electrucio/electrucio_updates/junk/guitar_preamplifier/docs/preamp_design.md

# AI-assisted redesign of a guitar preamplifier

I am not an expert on electronics. My actual background includes a PhD in digital audio processing, and my daily job involves software engineering, machine learning, signal processing... but no electronics at all. However, I recently realized I really enjoy learning about analog electronics, so here I am.

In this article, I explain how I have been experimenting with an AI agent to understand and adapt an existing guitar preamplifier to my requirements. I used AI for three main purposes:

* Understand an baseline existing design
* Brainstorm improvements suggestions
* Introduce changes in the existing design with verifiable metrics, using LTSpice simulation

Guitar preamplifier design from RedCircuits.com (https://www.dropbox.com/scl/fi/j1w2b3latuc1dzcs9ssm6/ia_usage_schema.png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)

I have learned a lot during the process, so I hope it can be inspiring for other people too. I invite any expert to provide feedback that help to improve the approach.

## 1. My requirements
Let's assume these are my requirements for a guitar amplifier.
* ✅ Input suitable for a standard guitar pickup
* ✅ Output suitable for a standard power amplifier
* ✅ Power voltage 0-15V
* ✅ Four knobs: Drive, Bass, Treble, Volume
* ✅ This is not a lab exercise: it has to work in real-world
* ✅ Discrete parts only, no op-amps.

## 2. Starting point: a schematic from redcircuits.com

For my exercise, I've used this project as a starting point: https://www.redcircuits.com/Page65.htm

Guitar preamplifier design from RedCircuits.com (https://www.redcircuits.com/GuitarPre.GIF)

Is this design enough for us?
* ❓ Input suitable for a standard guitar pickup
* ❓ Output suitable for a standard power amplifier
* ❌ Power voltage 0-15V
* ❌ Four knobs: Drive, Bass, Treble, Volume
* ❓ Properly designed, it should work as expected
* ✅ Discrete parts only, no op-amps.

Let's investigate if my requirements are met, with the help of LTSpice and Gemini.

## 3. LTSpice simulation

Let's begin with a simulation of the existing preamplifier: **does it work?**

### 3.1. Transient analysis using a 0.5 Vpeak, 1 kHz sine wave
According to [Rod Elliot](https://sound-au.com/articles/guitar-voltage.htm), a value of 0.5 Vpeak is rather high for guitar pickups, but still realistic for some models, so we will use this input amplitude in our analysis.

LTSpice simulation circuit (https://www.dropbox.com/scl/fi/t5rb5kocnawi6e06ufliy/original_design.png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)

After running this simulation, for `drive=0` (and the rest of parameters as shown in the figure) we get these results in our `.log` file:
| Node | Vmean | Vmin | Vmax | %THD |
| :--- | :--- | :--- | :--- | :--- |
| **V(in)** | 0.00 | -0.50 | 0.50 | 0.00% |
| **V(q1b)** | 2.50 | 2.12 | 2.88 | 0.00% |
| **V(q2c)** | 32.53 | 25.78 | 39.29 | 0.02% |
| **V(mid_in)** | 0.00 | -6.76 | 6.75 | 0.02% |
| **V(tone_in)** | 0.00 | -6.42 | 6.42 | 0.02% |
| **V(tone_out)**| 0.00 | -2.10 | 2.10 | 0.02% |
| **V(q3b)** | 27.57 | 25.47 | 29.67 | 0.02% |
| **V(q3e)** | 26.92 | 24.82 | 29.01 | 0.03% |
| **V(out)** | 0.00 | -2.09 | 2.09 | 0.03% |

If we activate the distortion (`drive=1`):
| Node | Vmean | Vmin | Vmax | %THD |
| :--- | :--- | :--- | :--- | :--- |
| **V(in)** | 0.00 | -0.50 | 0.50 | 0.00% |
| **V(q1b)** | 2.50 | 2.13 | 2.88 | 1.48% |
| **V(q2c)** | 32.81 | 27.56 | 39.13 | 9.16% |
| **V(mid_in)** | 0.00 | -5.21 | 6.32 | 9.16% |
| **V(tone_in)** | 0.00 | -3.09 | 3.35 | 23.26% |
| **V(tone_out)**| 0.00 | -1.73 | 1.74 | 33.37% |
| **V(q3b)** | 27.57 | 25.84 | 29.31 | 33.37% |
| **V(q3e)** | 26.92 | 25.19 | 28.65 | 33.37% |
| **V(out)** | 0.00 | -1.73 | 1.73 | 33.37% |

On on the other hand:
* Input impedance is 285kΩ 
* Output impedance is 10kΩ

Some preliminary conclusion about how well this design meets my requirements:

### 3.2. AC analysis: frequency response
Using a python script and `spicelib`, with the help of Gemini, I used `matplotlib` to create a beautiful plot that illustrates what happens with our preamplifier when you modify `bass` and `treble` controls. We will ignore `brightness` control.

LTSpice simulation circuit (https://www.dropbox.com/scl/fi/cmu691a0sbsxga6ana50k/original_design_ac_analysis.png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)

Not sure if this frequency response will produce a beautiful sound, but it is clearly working more or less as expected for both `bass` and `treble` controls.

## 4. Understanding each section of the circuit
So far, the results provided by the previous analysis look good, and Gemini a priori says the design is properly done. Now, let's spend some time understanding each part of the circuit. This might help in later stages, and is a good learning exercise.

### 4.1. The input stage

I know how to analyze basic transistor circuits, but I am not familiar with this specific topology. Gemini to the rescue:

> 1. The "Direct-Coupled Feedback Pair" (specifically an NPN-PNP pair)
This is the practical, schematic-level name.
> "Direct-Coupled" means there is no blocking capacitor between the collector of Q1 and the base of Q2. They are directly wired together.
> "Feedback Pair" means the two transistors operate as a single functional block bound by a global feedback loop.
> 2. The "Two-Stage Voltage-Series Feedback Amplifier"
This is the formal, academic name used in university physics and engineering books.
> "Voltage" means the feedback network (R7) is sampling the voltage at the output node (Q2's collector).
> "Series" means that the feedback is being injected into the emitter of Q1, which places it in series with the input signal arriving at the base.

After some iterations, I was able to find that **Two-Transistor Series-Feedback Gain Stages** is the right keyword for this topology:

LTSpice simulation circuit (https://www.dropbox.com/scl/fi/94ttidc72mrazcleyqloo/input_stage.png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)

I also wonder... why are we adding C3 here?

>In electronics literature, this specific component is universally known as a **Miller compensation capacitor** (or sometimes a **dominant-pole compensation capacitor**).
> Because your circuit uses global negative feedback (R7 and R8), there is a danger that at very high (radio) frequencies, natural phase shifts inside the transistors will turn that _negative_ feedback into _positive_ feedback, causing the amplifier to violently oscillate. C3 intentionally uses the "Miller Effect" to roll off the high-frequency gain of Q2, keeping the amplifier stable.

Ok, let's believe this.

**Understanding DC analysis**

After some iteration, I also understood the key aspects of this topology to perform a DC analysis (after opening all capacitors). If we do a rough approximation (ignoring $I_{2b}$, ignoring the effect of R4 on the voltage divider...):

* $V_{be}$ voltages are constant ~0.65v, so we know $V_{R6} = 0.65$ V.
* Since we know $V_{2b}$, we can know $I_{R6} = 0.65 / 2k2 = 295$µA, which is very similar to $I_{1c}$.
* As we know $I_{1c}$, we can know $I_{1b}$, since $I_{1b} = I_{1c}/\beta_{1} =295 / 344 = 0.86$µA.
* As we know $I_{1b}$ we can know the voltage in $R4$: $V_{R4} = I_{1b} R4 = 0.86 \cdot 10^{-6} \cdot 220 \cdot 10^{3} = 0.19$ V. We can then subtract the voltage in R4 to the voltage produced by the divider made of R3 and R5, and compute $V_{1b} = 57.08 \cdot \frac{33k}{(680k + 33k)} - 0.19=2.45$ V.
* Then we can compute $V_{1e} = V_{1b} - 0.6 = 2.45 - 0.6 = 1.85$, and then we can compute $I_{R8} = 1.85 / 330 = 5.6$ mA.
* $I_{R8} = I_{1e} + I_{2c}$. We know that $I_{1e} \approx I_{1c} = 295$µA, so we can estimate $I_{2c} = 5.6 - 0.295 = 5.3$mA.
* $V_{R7} = I_{2c} \cdot R7 = 5.3 \cdot 5k6 \approx 30$ V, so $V_{2c} = 30 + 1.85 \approx 32$ V. In LTSpice we get 32.52V instead of 32v because of the approximations mentioned before.

**Some considerations about AC analysis**

For AC analysis, we put our voltage supply to ground, and we consider all coupling and decoupling capacitors as close circuits, but what about Miller capacitor C3? Gemini suggests to treat it as an open circuit because we are interested in the audio bandwidth, and its reactance for these frequencies is very high.

Gemini says:
> When you strip away all the DC bias components, what you are left with is a textbook **Non-Inverting Operational Amplifier** made of discrete parts.

And it says that the amplification factor of a non-inverting op. amp is $$A_v \approx 1 + \frac{R_7}{R_8} \approx 17.97$$
In LTSpice I get $17.7$, so I guess it is correct as an approximation. Let's go on.

### 4.2. Diode clipper stage

Let's go with the analysis of the diode clipping stage in the mid section.
LTSpice simulation circuit (https://www.dropbox.com/scl/fi/odon4j8sfq4g9190pmovh/mid_section.png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)

Again: I ask Gemini to find references in well-known literature to understand the design used in this schematic.

> ### The Clipping Stage: Self-Biasing / Dynamic Clipper
>**Components involved:** P4, D1, D2, C5, C6, R11.
> In standard guitar pedal or preamp literature, this is known as a **Self-Biasing Clipper**, **Dynamic Diode Clipper**, or **RC-Biased Clipper**.
> 
> **How it works:**
> -   **Standard Hard Clipping:** Usually, anti-parallel diodes are connected directly to ground. When the signal exceeds the diode's forward voltage (about 0.2V-0.3V for the BAT46 Schottky diodes used here), it clips the wave completely flat. This sounds very harsh and buzzy ("solid-state" sounding). 
> -   **The Dynamic Twist:** In this circuit, the diodes do not go directly to ground. D1 connects to C5, and D2 connects to C6. When a loud signal hits and a diode conducts, it charges its respective capacitor. 
> -   **The Tube Emulation Effect:** As C5 and C6 charge up, they introduce a DC bias voltage that essentially _raises_ the clipping threshold for the next wave. The harder you play, the higher the threshold pushes back. As the note decays, the capacitors discharge through R11, lowering the threshold again.
> -   **The Result:** This creates a dynamic, "rubbery" feel that responds to pick attack, commonly referred to as "sag." It is a well-known solid-state technique used to emulate the asymmetrical duty-cycle shift and grid-clipping characteristics of an overdriven 12AX7 vacuum tube. P4 acts as a variable series resistor to control how hard the signal hits this network, essentially acting as a "Drive" or "Shape" control.

I used a guitar recording as input in V1 (`wavefile="../../audios/dry_guitar_5s.wav"`), and I was able to observe the behavior described by Gemini: the capacitors create a envelope follower, so the bias of the diode clipping is dynamic, allowing more dynamics than just the two diodes to ground. I also recorded the output using `.wave` LTSpice directive.

[Input audio](https://www.dropbox.com/scl/fi/7gtbvotlhn9sv4o5enonb/dry_guitar_5s.wav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)

[Output audio using current design with dynamic bias](https://www.dropbox.com/scl/fi/dpxmrngo414rtciz68wap/dynamicbias.mp3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)

[LTSpice simulation circuit](https://www.dropbox.com/scl/fi/le051e1n4w5vcthrkkw1h/current_design.png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
)

**What if we connect the diodes directly to ground?**

If we just put the two diodes to ground directly, ignoring R11, C5 and C6, what we get is a much more compressed waveform, closer to a fuzz.

LTSpice simulation circuit (https://www.dropbox.com/scl/fi/alwgj89ifa8pu3xz1xyx8/diodes_to_ground.png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)

[Output audio using diodes direct to ground](https://www.dropbox.com/scl/fi/p3ojo7l40lzo8owf800jt/directtoground.mp3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)

[LTSpice simulation circuit](https://www.dropbox.com/scl/fi/iqfelkhc3k6euz2srkwch/direct_to_ground.png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
)

**References about this dynamic-bias approach**
I have been investigating if this is a standard way of applying distortion in pedals or guitar preamps, but it does not seem to be very common. I found similar topologies for envelope followers, and I also found information about similar approaches in existing designs.

In "Solid-State Guitar Amplifiers" by Teemu Kyttälä, I was able to find references to a circuit that behaves similarly:

LTSpice simulation circuit (https://www.dropbox.com/scl/fi/iqkzpvlrjy71ldfnn4fuv/Captura-de-pantalla-2026-03-01-a-las-0.47.20.png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)

However, I was not able to find a previous design exactly as the one we are analyzing in our schematic.

### 4.3. Tone control
Let's remember again our tone stack, from original Red Circuits website:

LTSpice simulation circuit (https://www.dropbox.com/scl/fi/kuxyosqga2e4kmazmw1hs/Captura-de-pantalla-2026-03-01-a-las-2.31.31.png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)

Gemini describes this circuit this way:

> ### The Tone Control: The James Tone Network
> **Components involved:** C7, R12, P2 (Treble), P1 (Bass), R14, R15, R13, C9.
> 
> In literature, this specific topology is historically and technically known as the **James Tone Network** (created by E.J. James in 1949). However, in the guitar community, it is almost universally (and slightly incorrectly) referred to as a **Passive Baxandall** tone stack.
>
>**How it works:**
>
>-   Unlike the classic "FMV" (Fender/Marshall/Vox) tone stack which is highly interactive and naturally has a massive mid-scoop, the James network is designed to be much flatter and more independent.
>    
>-   **Treble Path:** The high frequencies pass through C7 and are controlled by P2.
>   
>-   **Bass Path:** The low frequencies are blocked by C7 but pass through R12 to be controlled by P1.
>    
> -   **Characteristics:** It provides genuine bass and treble _cut and boost_ relative to the baseline insertion loss of the circuit. If you set both P1 and P2 to 50% (as hinted by the `.param pos2=0.5` and `pos3=0.5` tags), you will get a relatively flat frequency response. The addition of R14, R15, and C9 in this specific variation acts as a shaping network to set the exact crossover frequency and control the midrange behavior between the two pots.
> 
> It looks like a very thoughtfully designed solid-state preamp aimed at capturing tube-like dynamics rather than just raw distortion.

I have been reviewing the topologies shown in https://www.guitarscience.net/tsc/james_2.htm, but I didn't find my exact topology. The most similar one is the James Tone Stack "Passive / Single Bass Capacitor":

LTSpice simulation circuit (https://www.dropbox.com/scl/fi/3uqhm2lyrnx169q2ykbwy/Captura-de-pantalla-2026-03-01-a-las-2.37.37.png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)

But it is not exactly the same! $C_B$ is not present in our design, and R3 (which in our case would be R14) is not connected to the same node. I was not able to find a reference about my specific tone stack, but I guess the main ideas behind it should be very similar.

### 4.4. The Output Stage: Bootstrapped Buffer (Q3)
LTSpice simulation circuit (https://www.dropbox.com/scl/fi/qlct4umq7ib7s93w4waea/output_buffer.png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)

> Based on the schematic provided, you are looking at a classic **Bootstrapped Emitter Follower** (also known as a Common Collector amplifier) circuit.
> 
> Here is a detailed breakdown of the topology and the specific role of each component.
> ### **Circuit Topology: The Bootstrapped Emitter Follower**
> The core of this circuit is the NPN transistor configured as an emitter follower. In a standard emitter follower, the input is applied to the base, the output is taken from the emitter, and the voltage gain is approximately 1 (unity). Its primary purpose is to act as a **buffer**: it provides a very high input impedance and a low output impedance, allowing you to drive a heavier load without loading down the previous stage.
>
>However, a standard biasing network (like a simple voltage divider) normally lowers the overall input impedance. This circuit solves that using a clever technique called **bootstrapping** (via C11 and R18), which artificially inflates the input impedance to a much higher value.
>
>---
>
>### **Role of the Components**
>
>#### **1. Power Supply & Decoupling**
>
>* **V2 (60V):** The main DC power supply for this stage.
>* **R21 ($330\Omega$) & C13 ($220\mu F$):** These form an RC low-pass filter (often called a decoupling or "RC snubber" network). They filter out high-frequency noise and power supply ripples from the 60V rail, providing a clean, quiet 57.08V DC supply to the transistor's collector.
>#### **2. The Active Component**
>
>* **Q3 (BC546B):** An NPN bipolar junction transistor (BJT) acting as the current buffer. It amplifies the current of the input signal while keeping the voltage level essentially the same (minus the base-emitter voltage drop, $V_{BE} \approx 0.65V$).
>
>#### **3. DC Biasing Network**
>
>These components establish the steady state (DC quiescent operating point) of the transistor so it stays in its active region to amplify AC signals without clipping.
>
>* **R17 ($100k\Omega$) & R19 ($100k\Omega$):** These form a voltage divider that sets an intermediate DC voltage (28.22V) at the junction between them.
>* **R20 ($10k\Omega$):** The emitter load resistor. It sets the quiescent DC current flowing through the transistor. Because the emitter sits at about 26.9V, the current is roughly $I_E = \frac{26.9V}{10k\Omega} \approx 2.7mA$.
>
>#### **4. The Bootstrapping Network (The Clever Part)**
>
>* **R18 ($100k\Omega$):** Provides the actual DC bias current to the base of Q3 from the R17/R19 voltage divider.
>* **C11 ($10\mu F$):** **The bootstrap capacitor.** This is the secret sauce of this topology. It connects the emitter output back to the junction of R17, R18, and R19.
>* **How it works:** Because the emitter follower has a voltage gain of almost 1, the AC voltage at the emitter is nearly identical to the AC voltage at the base. C11 feeds this AC voltage back to the bottom of R18. Consequently, both ends of R18 are bouncing up and down with the exact same AC signal.
>* If there is no AC voltage *difference* across R18, there is no AC current flowing through it. By Ohm's law, if a resistor draws no AC current, its effective AC resistance appears to be near infinity. This prevents the biasing network from lowering the input impedance of the amplifier.
>
>#### **5. Signal Coupling & Output**
>
>* **C10 ($10\mu F$):** The input coupling capacitor. It blocks any incoming DC voltage from messing up the delicate bias of the base, but allows the AC audio/signal to pass through.
>* **C12 ($10\mu F$):** The output coupling capacitor. It strips away the large 26.9V DC offset at the emitter, allowing only the AC signal to pass to the next stage.
>* **P3a & P3b (Potentiometer, $10k\Omega$ total):** This acts as an output volume control or attenuator. The `.param pos4=0.00001` indicates that the wiper (the `OUT` node) is currently set extremely low, meaning it's heavily attenuating the signal right now in your simulation.

---

Quite clear! I searched a bit more about this "bootstrapping", and it seems Gemini was totally right about it.

LTSpice simulation circuit (https://www.dropbox.com/scl/fi/ldesm1puw3dznlmccbswx/Captura-de-pantalla-2026-03-01-a-las-3.33.27.png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)

LTSpice simulation circuit (https://www.dropbox.com/scl/fi/7p5xlqxnkde86ktb84x49/Captura-de-pantalla-2026-03-01-a-las-3.33.34.png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)

# 5. IA-assisted redesign of the circuit
After all analysis carried out, I think we can add some details about whether the original design meets our requirements or not.

* 🟡 Input suitable for a standard guitar pickup
    * 🟡 The input impedance of ~280kΩ is a bit low, according "Solid-State Guitar Amplifiers" by Teemu Kyttälä (he suggests >1MΩ). We can consider this a point to revisit later.
* ✅🟡 Output suitable for a standard power amplifier
    * ✅ The output impedance can be easily controlled thanks to the use of the bootstrapped buffer
    * 🟡 The voltage of the output signal, especially when the `drive` is on, might be rather low. The global gain of the whole circuit should be revisited later.
* ❌ Power voltage 0-15V
* 🟡❌ Four knobs: Drive, Bass, Treble, Volume
    * ✅ 3 knobs implemented that are welcome: Bass, Treble, Volume
    * ❌ but the knob Drive is not implemented. At the moment it is just a switch
* ✅🟡 Properly designed, it should work as expected
    * The design is ok, but a careful review is needed of aspects like: input impedance might be too low, gain might be too low (especially when `drive=1`), frequency response to very low frequencies might not be ideal, etc. We will revisit these aspects.
* ✅ Discrete parts only, no op-amps.

If we have to prioritize two inmediate changes, so that the first version of the circuit is functional:

* ❌ Power voltage 0-15V
* ❌ Addition of a drive knob

We will continue with other aspects later.

## 5.1. IA-assisted iterations: main approach
In order to introduce incremental changes in the design, we use the following pattern:

* We provide the `.net` and `.log` file of the baseline design. We add as much information as possible in `.log` using directives like `.four`, `.meas`, etc. Gemini helps for this. We can also add a picture of the schematic, since it is also able to understand it, and might complement the other inputs.
* We ask Gemini to analyze the design first, and we check that the understanding of the circuit makes sense.
* We provide Gemini with specific requirements **that can be measured** with the output of LTSpice. We ask it to iterate in order to meet the requirements.
* Manually, we apply the changes suggested by Gemini in LTSpice, simulate again, and send again the `.net` and `.log`. The `.net` is good in every iteration, so that Gemini makes sure the changes have been correctly implemented.
* We iterate until the specs are met.

I didn't spend much time with ellaborated prompts, but I got good results anyway. Maybe, some more ellaborated prompting engineering could lead to even better results.

## 5.1. Iteration 1: adapting power supply and adding a drive knob

This part has been iterated almost completely with Gemini. I share the conversation [here](https://github.com/electrucio/electrucio_updates/blob/main/guitar_preamplifier/docs/chats/red_circuits_analysis_and_iteration_1.pdf).

The main changes applied, summarized by Gemini:

LTSpice simulation circuit (https://www.dropbox.com/scl/fi/clhneso7vohjwp7vhqjg7/Captura-de-pantalla-2026-03-11-a-las-0.28.26.png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)

> The following table summarizes the primary structural and technical changes:
> ### 1. Power Supply and Headroom Management
> * **Voltage Reduction:** The power supply was dropped from **60V** down to **15V**.
>
> * **Headroom Philosophy:** The original design relied on massive voltage swing for "infinite" clean headroom. The redesign uses a lower rail to intentionally allow for organic transistor saturation when driven hard.
>
> * **Power Filtering:** Resistor **R21** was reduced from **330 $\Omega$** to **100 $\Omega$** to minimize DC voltage drop and preserve precious headroom on the lower 15V supply.
>
> ### 2. Input Stage: Variable Gain vs. Fixed Gain
>
> * **New Drive Topology:** The redesign introduces a new variable-gain architecture using a **1k $\Omega$ Reverse Log (C-Taper) potentiometer (P4)**.
>
> * **AC Bypassing:** P4 is placed in an AC-coupled path to ground off the emitter of Q1, allowing the user to sweep gain from roughly **1.5x (clean)** to **48x (heavy overdrive)** without upsetting the DC bias.
>
> * **DC Bias Stabilization:** To accommodate the 15V rail and the new gain structure, **R3** was changed from **680k $\Omega$** to **56k $\Omega$** and **R7** from **5.6k $\Omega$** to **220 $\Omega$** to anchor the Q2 collector at roughly **7.5V**.
>
> ### 3. Output Stage: Active Makeup Gain
> *  **Topology Shift:** In the 60V version, **Q3** was a unity-gain **Emitter Follower (Buffer)**. In the 15V redesign, it is reconfigured as a **Common Emitter amplifier**.
>
> * **Makeup Gain:** This change provides a **~7x voltage boost** to recover signal lost in the passive tone stack and clipping diodes, ensuring the output is hot enough (**~1V RMS**) to drive a power amplifier.
>
> ### 4. Distortion and Tone Shaping
>
> * **Clipping Diodes:** The redesign swaps **BAT46WJ Schottky diodes** (0.3V threshold) for **1N4148 Silicon diodes** (0.6V threshold). This results in a more dynamic, "amp-like" crunch with less compression.
>
>* **Continuous Control:** The original "binary" Drive switch was replaced by the continuous P4 potentiometer control, allowing a sweep from **0.07% THD (clean)** to **~36% THD (saturated)**.
