electrucio/electrucio_updates/junk/guitar_preamplifier/schematics/redcircuits_design/red_circuits_design.asc

C1: Cap; 10µ
C2: Cap; 47µ
C3: Cap; 47p
C4: Cap; 10µ
C5: Cap; 10µ
C6: Cap; 10µ
C7: Cap; 15n
C8: Cap; 22n
C9: Cap; 470n
C10: Cap; 10µ
C11: Cap; 10µ
C12: Cap; 10µ
C13: Cap; 220µ
D1: schottky; BAT46WJ
D2: schottky; BAT46WJ
P1a: Res; {P1a}
P1b: Res; {P1b}
P2a: Res; {P2a}
P2b: Res; {P2b}
P3a: Res; {P3a}
P3b: Res; {P3b}
Q1: npn; BC546B
Q2: pnp; BC556B
Q3: npn; BC546B
R1: Res; 68K
R3: Res; 680K
R4: Res; 220K
R5: Res; 33k
R6: Res; 2K2
R7: Res; 5k6
R8: Res; 330
R9: Res; 47k
R10: Res; 470
R11: Res; 4k7
R12: Res; 10k
R13: Res; 100
R14: Res; 47
R15: Res; 47
R16: Res; 2k2
R17: Res; 100k
R18: Res; 100k
R19: Res; 100k
R20: Res; 10k
R21: Res; 330
S1: sw
S2: sw
V1: Voltage; SINE(0 {in_amplitude} {in_freq})
V2: voltage; 60
V4: Voltage; {brightness}
V5: Voltage; {drive}
Named nets: 0, Q1B, Q1C, Q1E, Q2C, Q2E, Q3B, Q3C, Q3E, OUT, MID_IN, C5, C6, IN, DRIVE, BRIGHT, TONE_OUT, TONE_IN
.param treble=0.5
.param drive=0.0
.func potlog_a(ohm, rot) {ohm * (rot ** 3.3) + 1m}
.param P2b = potlin_b(10k, treble)
.param P2a = potlin_a(10k, treble)
.param P1b = potlin_b(10k, bass)
.param P1a = potlin_a(10k, bass)
.param bass=0.5
.param P3b = potlog_b(10k, vol)
.param P3a = potlog_a(10k, vol)
.param vol=1
.func potlog_b(ohm, rot) {ohm * (1 - (rot ** 3.3)) + 1m}
.func potlin_a(ohm, rot) {ohm * rot + 1m}
.func potlin_b(ohm, rot) {ohm * (1 - rot) + 1m}
.model SW SW(Ron=1m Roff=1G Vt=0.5 Vh=0.1)
.param brightness=0.0
.param in_amplitude=0.25
.param in_freq=1000
.options plotwinsize=0
.param t_start = 100m
.param tran_window = 10 / {in_freq}
.param t_stop = {t_start + tran_window}
.param step = 1 / {1000 * in_freq}
.tran {step} {t_stop} {t_start} {step}
.meas tran Vin_mean AVG V(in)
.meas tran Vin_max MAX V(in)
.meas tran Vin_min MIN V(in)
.meas tran Vin_rms RMS V(in)
.four {in_freq} 10 10 V(in)
.meas tran Vq1b_mean AVG V(Q1B)
.meas tran Vq1b_max MAX V(Q1B)
.meas tran Vq1b_min MIN V(Q1B)
.meas tran Vq1b_rms RMS V(Q1B)
.four {in_freq} 10 10 V(Q1B)
.meas tran Vq2c_mean AVG V(Q2C)
.meas tran Vq2c_max MAX V(Q2C)
.meas tran Vq2c_min MIN V(Q2C)
.meas tran Vq2c_rms RMS V(Q2C)
.four {in_freq} 10 10 V(Q2C)
.meas tran Vmidin_mean AVG V(MID_IN)
.meas tran Vmidin_max MAX V(MID_IN)
.meas tran Vmidin_min MIN V(MID_IN)
.meas tran Vmidin_rms RMS V(MID_IN)
.four {in_freq} 10 10 V(MID_IN)
.meas tran Vtonein_mean AVG V(TONE_IN)
.meas tran Vtonein_max MAX V(TONE_IN)
.meas tran Vtonein_min MIN V(TONE_IN)
.meas tran Vtonein_rms RMS V(TONE_IN)
.four {in_freq} 10 10 V(TONE_IN)
.meas tran Vtoneout_mean AVG V(TONE_OUT)
.meas tran Vtoneout_max MAX V(TONE_OUT)
.meas tran Vtoneout_min MIN V(TONE_OUT)
.meas tran Vtoneout_rms RMS V(TONE_OUT)
.four {in_freq} 10 10 V(TONE_OUT)
.meas tran Vq3b_mean AVG V(Q3B)
.meas tran Vq3b_max MAX V(Q3B)
.meas tran Vq3b_min MIN V(Q3B)
.meas tran Vq3b_rms RMS V(Q3B)
.four {in_freq} 10 10 V(Q3B)
.meas tran Vq3e_mean AVG V(Q3E)
.meas tran Vq3e_max MAX V(Q3E)
.meas tran Vq3e_min MIN V(Q3E)
.meas tran Vq3e_rms RMS V(Q3E)
.four {in_freq} 10 10 V(Q3E)
.meas tran Vout_mean AVG V(OUT)
.meas tran Vout_max MAX V(OUT)
.meas tran Vout_min MIN V(OUT)
.meas tran Vout_rms RMS V(OUT)
.four {in_freq} 10 10 V(OUT)
* --- Improved Impedance & Clipping Measurements ---
* 1. Large-Signal Input Impedance (Zin)
.meas tran Iin_peak MAX I(R1)
.meas tran Iin_val_min MIN I(R1)
.meas tran Zin_large PARAM (Vin_max-Vin_min)/(Iin_peak-Iin_val_min)
* 2. First Stage Output Impedance (Looking into Tone Stack)
.meas tran Ic4_peak MAX I(C4)
.meas tran Ic4_min MIN I(C4)
.meas tran Zout_stage1 PARAM (Vq2c_max-Vq2c_min)/(Ic4_peak-Ic4_min)
* 3. Diode Clipping Characterization
.meas tran Idiodes_peak MAX I(D1)
.meas tran P_clipping AVG V(TONE_IN)*I(D1)
* 4. Effective Output Impedance (using C12 as a proxy for the volume pot)
.meas tran Iout_peak MAX I(C12)
.meas tran Iout_min MIN I(C12)
.meas tran Zout_eff PARAM (Vout_max-Vout_min)/(Iout_peak-Iout_min)
* 5. Gain & Symmetry
.meas tran Voltage_Gain PARAM Vout_rms/Vin_rms
.meas tran Clip_Symmetry PARAM (Vout_max/abs(Vout_min))
* Re-run Fourier for the Pot to ensure it is captured
.four {in_freq} 10 10 I(C12)
