electrucio/electrucio_updates/powersupply/psu.asc

C1: Cap; 0.33µ
C2: Cap; 0.33µ
C3: Cap; 0.33µ
C4: Cap; 0.33µ
C5: Cap; 0.33µ
C6: Cap; 10000µ
D1: zener; BZX84C30VLY
D2: zener; BZX84C30VLY
D3: zener; BZX84C30VLY
D4: zener; BZX84C30VLY
D5: zener; BZX84C30VLY
D6: zener; BZX84C30VLY
D7: zener; BZX84C30VLY
D8: zener; BZX84C30VLY
D9: zener; BZX84C30VLY
D10: zener; BZX84C30VLY
D11: Diode; 1N5408
D12: Diode; 1N5408
D13: Diode; 1N5408
D14: Diode; 1N5408
L1: ind2; 50
L2: ind2; 50
L3: ind2; 50
L4: ind2; 50
L5: ind2; 50
L6: ind2; 50
L7: ind2; 50
L8: ind2; 50
L9: ind2; 50
L10: ind2; 50
L11: ind2; 136m
L12: ind2; 136m
L13: ind2; 136m
L14: ind2; 136m
L15: ind2; 136m
L16: ind2; 136m
L17: ind2; 136m
L18: ind2; 136m
L19: ind2; 136m
L20: ind2; 136m
R1: Res; 60
R2: Res; 80
R3: Res; 70
R4: Res; 80
R5: Res; 60
R6: Res; 50
R7: Res; 50
R8: Res; 50
R9: Res; 50
R10: Res; 50
R11: Res; 0.2
R12: Res; 0.2
R13: Res; 0.2
R14: Res; 0.2
R15: Res; 0.2
R16: Res; 0.1
R17: Res; 0.1
R18: Res; 0.1
R19: Res; 0.1
R20: Res; 0.1
R21: Res; 250
R22: Res; 100
R23: Res; 100
R24: Res; 100
R25: Res; 100
R26: Res; 100
R28: Res; 0.001
R_NEUTRAL: Res; 1G
U1: Relay_2A2B
U2: Relay_2A2B
U3: Relay_2A2B
U4: Relay_2A2B
U5: Relay_2A2B
U6: Relay_2A2B
U7: Relay_2A2B
U8: Relay_2A2B
U9: Relay_2A2B
U10: Relay_2A2B
V1: voltage; SINE(0 325 50)
Named nets: LIVE, NEUTRAL, 0, VAC+, VAC-, VRAW+
.tran 0 10.25 0.15 1m
K1 L1 L11 0.99
K2 L2 L12 0.99
K3 L3 L13 0.99
K4 L4 L14 0.99
K5 L5 L15 0.99
K6 L6 L16 0.99
K7 L7 L17 0.99
K8 L8 L18 0.99
K9 L9 L19 0.99
K10 L10 L20 0.99
.model 1N5408 D(Is=63.0n Rs=14.1m Bv=1000 Ibv=10u Cjo=53p M=0.333 N=1.30 Eg=1.11)
