electrucio/electrucio_updates/powersupply/Relay_SR4D.asc

A1: diffschmitt; Vt={(Von+Voff)/2} Vh={(Von-Voff)/2}
A2: buf; Td={Tfly}
A4: and
A7: and
L1: ind; {Lcoil}
R1: res; {Rcoil}
R2: res; 1k
R3: res; 1k
S1: sw
S2: sw
S3: sw
S4: sw
V1: voltage; PULSE(0 24 0 10n 10n .5 1)
V2: voltage; 5
Named nets: 0, Coil+, Coil-, SW_On, SW_Off, NC, NO, VCC
.tran 0 2 0
.param Von=18 Voff=2.4 Tfly=20m Rcoil=720 Lcoil=1 Ron=10m Roff=1G
.model sw sw(Vt=0.5 Ron={Ron} Roff={Roff})
Break before Make Logic
