electrucio/electrucio_updates/junk/elcheapo/ltspice/el_cheapo.asc

B1: bv; V=V(ENVELOPE) * V(TONE)
C1: Cap; 4700µ
C2: Cap; 15µ
C3: Cap; 200µ
C4: Cap; 68p
C5: Cap; 220µ
C6: Cap; 20µ
C7: Cap; 100n
C8: Cap; 1000µ
C9: Cap; 470µ
C10: Cap; 4700µ
D1: Diode; 1N5408
D2: Diode; 1N5408
D3: Diode; 1N5408
D4: Diode; 1N5408
D5: diode; 1N4148
D6: diode; 1N4148
D7: diode; 1N4148
D8: zener; 1N4755A
L1: ind2; 10H
L2: ind2; 0.275H
L3: ind2; 0.010H
Q1: pnp; BC559
Q2: npn; BD139
Q3: pnp; BD140
Q4: npn; BD139
Q5: npn; 2SD896
Q6: npn; 2SD896
Q7: npn
Q8: npn
R1: Res; 15
R2: Res; 0.5
R3: Res; 1k
R4: Res; 1k
R5: Res; 2Meg7
R6: Res; 150k
R7: Res; 33k
R8: Res; 1k
R9: Res; 47k
R10: Res; 18k
R11: Res; 18k
R12: Res; 330
R13: Res; 6k8
R14: Res; 1k5
R15: Res; 27
R16: Res; 1K
R17: Res; 0R47
R18: Res; 1K
R19: Res; 0R47
R20: Res; 18
R21: Res; 0.03
R22: Res; 0.03
R23: Res; 0.1
R24: Res; 1k
R25: Res; 1k
R26: Res; 8
V1: voltage; SINE(0 325 50); Rser=0.1
V2: voltage; SINE(0 2 1000)
V3: voltage; PWL(5000m 0 5005m 1 5015m 0.6 5300m 0.6 5350m 0)
V4: voltage; 41.5
VR1: Res; 100k
Named nets: 0, VRAW+, VE+, ENVELOPE, TONE, V+, OUT
K1 L1 L2 L3 0.99
.tran 0 6.5 4.5 1u
* TIP35C (NPN Power Transistor: 100V, 25A, 125W)
.model TIP35C NPN(IS=2.45E-11 BF=95 VAF=100 IKF=8 ISE=3.52E-11 NE=1.5 BR=2.8 VAR=100 IKR=0.3 ISC=1E-13 NC=1.2 RE=0.05 RC=0.03 RB=0.1 CJC=7.50E-10 VJC=0.75 MJC=0.33 CJE=1.50E-09 VJE=0.75 MJE=0.33 TF=5.00E-08 TR=2.00E-06 VCEO=100 ICrating=25 mfg=ST)
* BC559 (PNP Small Signal, Low Noise: 30V, 100mA)
.model BC559 PNP(IS=1.04E-14 NF=1.0028 BF=397.6 VAF=109.9 IKF=0.08 ISE=6.55E-15 NE=1.5 BR=1.868 VAR=24 IKR=0.012 ISC=1.00E-14 NC=1.5 RB=28.1 RC=0.86 RE=0.28 CJC=5.50E-12 VJC=0.3 MJC=0.3 CJE=1.15E-11 VJE=0.65 MJE=0.33 TF=4.50E-10 TR=1.00E-08 VCEO=30 ICrating=0.1 mfg=OnSemi)
* BD139 (NPN Medium Power: 80V, 1.5A)
.model BD139 NPN(IS=2.37E-13 VAF=100 BF=120 IKF=0.5 ISE=1E-14 NE=1.5 BR=2 VAR=20 IKR=0.1 RE=0.1 RC=0.1 RB=1 CJC=4.5E-11 VJC=0.7 MJC=0.33 CJE=1.5E-10 VJE=0.7 MJE=0.33 TF=5E-9 TR=1E-7 VCEO=80 ICrating=1.5 mfg=Philips)
* BD140 (PNP Medium Power Complementary: 80V, 1.5A)
.model BD140 PNP(IS=2.37E-13 VAF=100 BF=120 IKF=0.5 ISE=1E-14 NE=1.5 BR=2 VAR=20 IKR=0.1 RE=0.1 RC=0.1 RB=1 CJC=6E-11 VJC=0.7 MJC=0.33 CJE=2E-10 VJE=0.7 MJE=0.33 TF=5E-9 TR=1E-7 VCEO=80 ICrating=1.5 mfg=Philips)
* 2SD896 (NPN Audio Power Transistor: 150V, 10A, 100W)
.model 2SD896 NPN(IS=1.0E-11 BF=120 VAF=150 IKF=7.0 ISE=1.0E-11 NE=1.5 BR=3.0 VAR=20 IKR=0.5 RE=0.05 RC=0.05 RB=0.2 CJC=2.5E-10 VJC=0.7 MJC=0.33 CJE=8.0E-10 VJE=0.7 MJE=0.33 TF=2.0E-8 TR=1.0E-6 VCEO=150 ICrating=10 mfg=Sanyo)
