electrucio/electrucio_updates/(list of files, drawings)

Other design files:
junk/guitar_preamplifier/easyeda/jlh1969/PCB_PCB_jlh1969_2026-03-17.json
junk/guitar_preamplifier/easyeda/jlh1969/SCH_jlh1969_2026-03-17.json
