electrucio/electrucio_updates/guitar_amplifier/kicad/poweramp/poweramp.kicad_pcb

## KiCad design guitar_amplifier/kicad/poweramp/poweramp.kicad_pcb (2026-06-14)

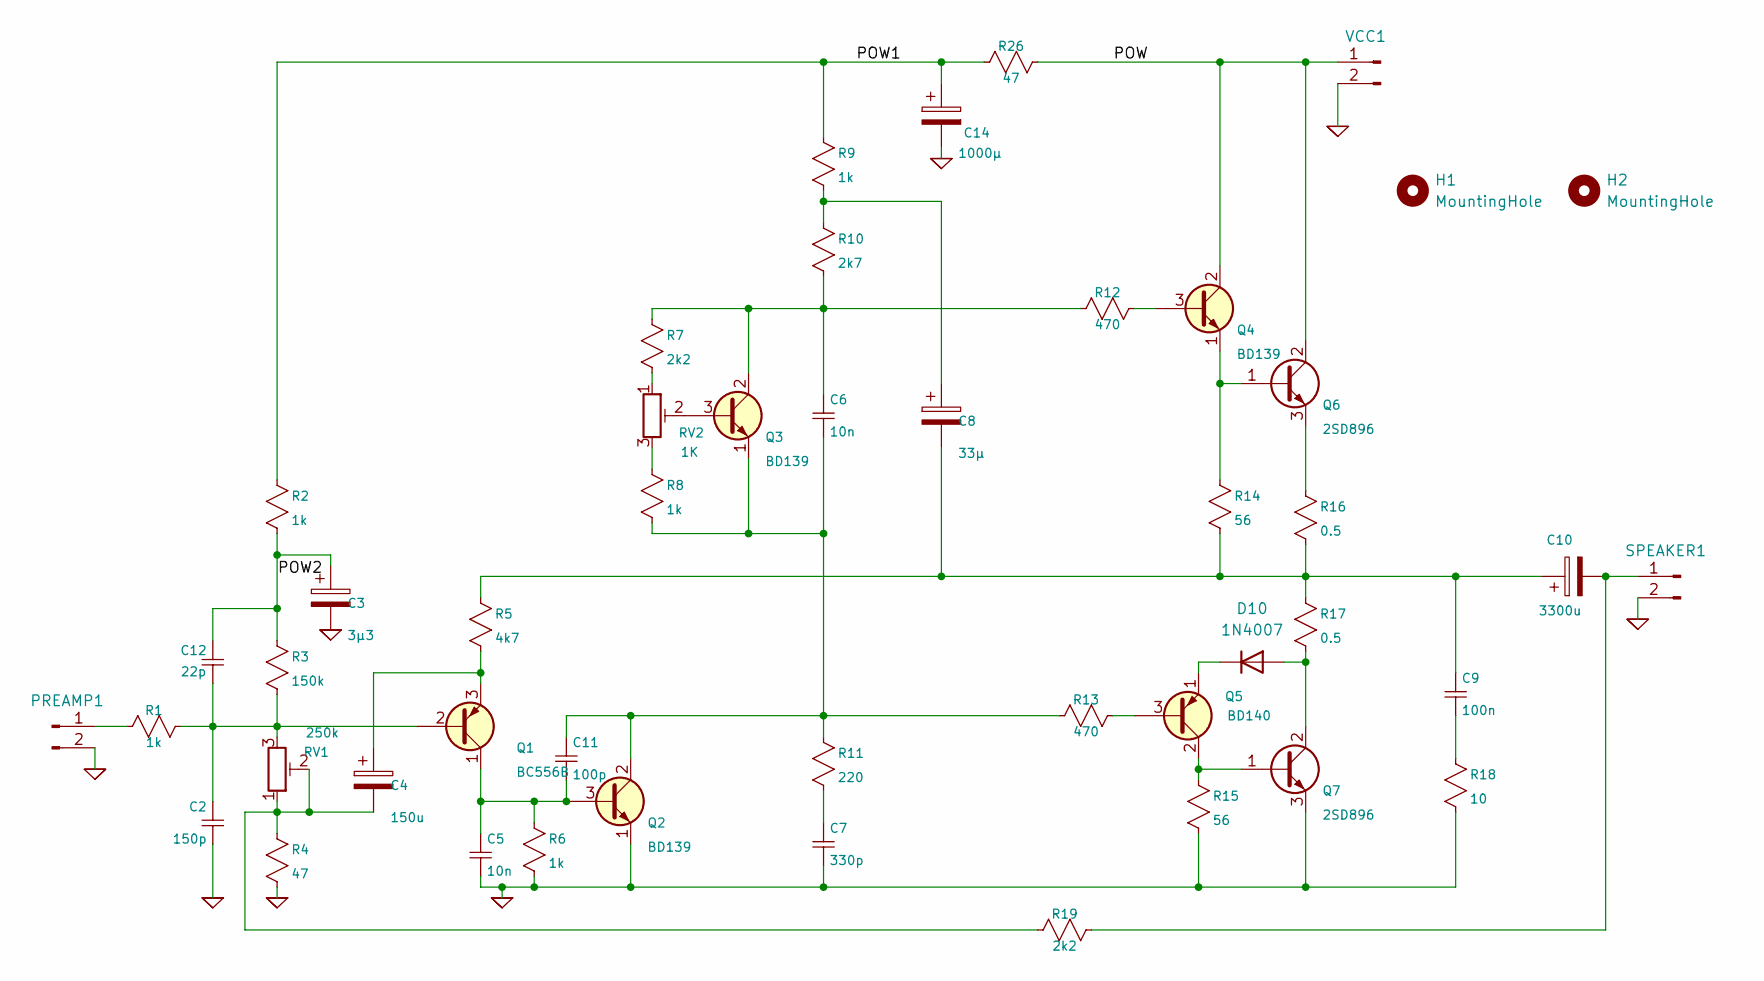
[picture p1: schematic poweramp.kicad_sch]

Parts:
C2: 150p; C_Rect_WIMA_1uF_CNC_LargePads
C3: 3µ3; CP_Radial_D6.3mm_P2.50mm
C4: 150u; CP_Radial_220u_8mm_3.5mm_largerpads
C5, C6: 10n; C_Rect_WIMA_1uF_CNC_LargePads
C7: 330p; C_Rect_WIMA_1uF_CNC_LargePads
C8: 33µ; CP_Radial_D8.0mm_P3.80mm
C9: 100n; C_Rect_WIMA_1uF_CNC_LargePads
C10: 3300u; CP_Radial_D22.0mm_P10.00mm_SnapIn
C11: 100p; C_Rect_WIMA_1uF_CNC_LargePads
C12: 22p; C_Disc_D4.3mm_W1.9mm_P5.00mm_largerpads
C14: 1000µ; CP_Radial_220u_12.5mm_5mm_largerpads
D10: 1N4007; D_DO-41_SOD81_P10.16mm_Horizontal
H1, H2: MountingHole; MountingHole_3.5mm
PREAMP1: JST_XH_B2B-XH-A_1x02_P2.50mm_Vertical_ovalpads
Q1: BC556B; TO-92_Inline_Wide_CBE
Q2, Q3, Q4: BD139; TO-126-3_Vertical_ECB
Q5: BD140; TO-126-3_Vertical_ECB
Q6, Q7: 2SD896; TO-3P-3_Vertical_BCE
R1, R2, R6, R8, R9: 1k; R_Axial_DIN0207_L6.3mm_D2.5mm_P10.16mm_Horizontal_LargerPads
R3: 150k; R_Axial_DIN0207_L6.3mm_D2.5mm_P10.16mm_Horizontal_LargerPads
R4: 47; R_Axial_DIN0207_L6.3mm_D2.5mm_P10.16mm_Horizontal_LargerPads
R5: 4k7; R_Axial_DIN0207_L6.3mm_D2.5mm_P10.16mm_Horizontal_LargerPads
R7, R19: 2k2; R_Axial_DIN0207_L6.3mm_D2.5mm_P10.16mm_Horizontal_LargerPads
R10: 2k7; R_Axial_DIN0207_L6.3mm_D2.5mm_P10.16mm_Horizontal_LargerPads
R11: 220; R_Axial_DIN0207_L6.3mm_D2.5mm_P10.16mm_Horizontal_LargerPads
R12, R13: 470; R_Axial_DIN0207_L6.3mm_D2.5mm_P10.16mm_Horizontal_LargerPads
R14, R15: 56; R_Axial_DIN0207_L6.3mm_D2.5mm_P10.16mm_Horizontal_LargerPads
R16, R17: 0.5; R_Axial_Power_L25.0mm_W9.0mm_P30.48mm
R18: 10; R_Axial_DIN0207_L15mm_D5mm_P22mm_Horizontal_LargerPads
R26: 47; R_Axial_DIN0207_L15mm_D5mm_P22mm_Horizontal_LargerPads
RV1: 250k; Potentiometer_Piher_PT-6-V_Vertical_largerpads
RV2: 1K; Potentiometer_Piher_PT-10-V_Vertical_largerpads
SPEAKER1: JST_XH_B2B-XH-A_1x02_P2.50mm_Vertical_ovalpads
VCC1: JST_XH_B2B-XH-A_1x02_P2.50mm_Vertical_ovalpads

Connections:
0: C2.2, C3.2, C5.2, C7.2, C14.2, PREAMP1.2, Q2.1 (E), Q7.3 (E), R4.2, R6.2, R15.2, R18.2, SPEAKER1.2, VCC1.2
/POW: Q4.2 (C), Q6.2 (C), R26.1, VCC1.1
/POW1: C14.1, R2.1, R9.1, R26.2
/POW2: C3.1, C12.1, R2.2, R3.1
unnamed: C4.2, R4.1, R19.2, RV1.1, RV1.2
unnamed: C7.1, R11.2
unnamed: C8.1, R9.2, R10.1
unnamed: C9.2, R18.1
unnamed: C8.2, C9.1, C10.1, R5.1, R14.2, R16.2, R17.1
unnamed: D10.2 (A), Q7.2 (C), R17.2
unnamed: D10.1 (K), Q5.1 (E)
unnamed: PREAMP1.1, R1.2
unnamed: C2.1, C12.2, Q1.2 (B), R1.1, R3.2, RV1.3
unnamed: C5.1, C11.2, Q1.1 (C), Q2.3 (B), R6.1
unnamed: C4.1, Q1.3 (E), R5.2
unnamed 15: C6.2, C11.1, Q2.2 (C), Q3.1 (E), R8.2, R11.1, R13.2; also elsewhere on the board
unnamed 16: Q3.3 (B), RV2.2; also elsewhere on the board
unnamed 17: C6.1, Q3.2 (C), R7.1, R10.2, R12.2; also elsewhere on the board
unnamed: Q4.3 (B), R12.1
unnamed: Q4.1 (E), Q6.1 (B), R14.1
unnamed: Q5.3 (B), R13.1
unnamed: Q5.2 (C), Q7.1 (B), R15.1
unnamed: Q6.3 (E), R16.1
unnamed: R7.2, RV2.1
unnamed: R8.1, RV2.3
unnamed: C10.2, R19.1, SPEAKER1.1

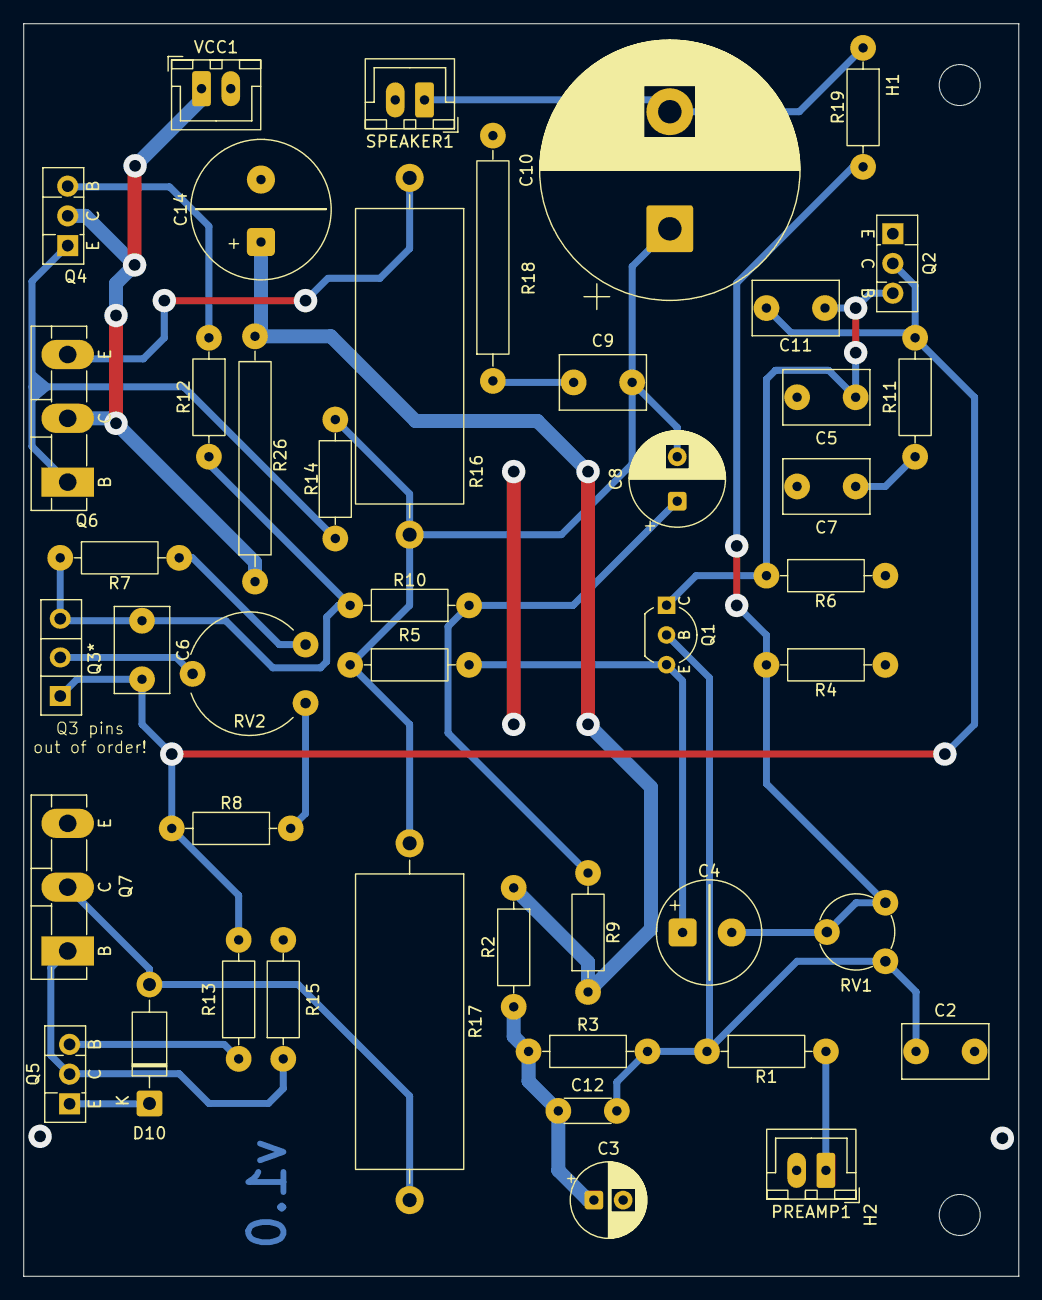
[picture p2: board poweramp.kicad_pcb from above]

Board: 2 copper layers, 85.0 x 107.0 mm, 47 parts (0 on the bottom side), 26 nets.

Other parts of the board:
Q3*: BD139; TO-126-3_Vertical

Their connections:
unnamed 15: Q3*.1 (E); also elsewhere on the board
unnamed 16: Q3*.3 (B); also elsewhere on the board
unnamed 17: Q3*.2 (C); also elsewhere on the board
