electrucio/electrucio_updates/guitar_amplifier/kicad/preamp/preamp.kicad_pcb

## KiCad design guitar_amplifier/kicad/preamp/preamp.kicad_pcb (2026-06-14)

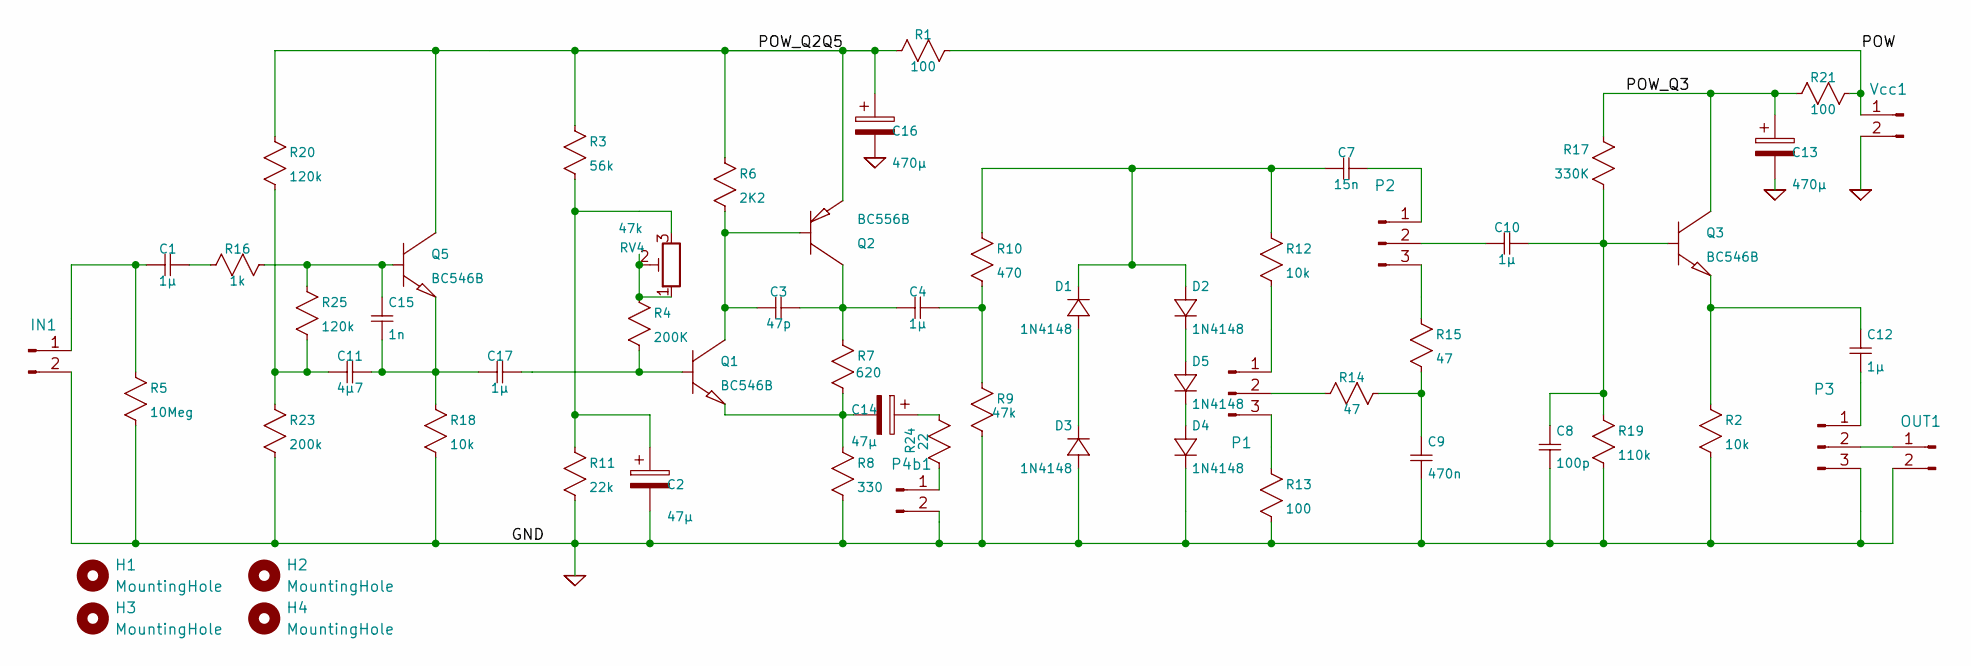
[picture p3: schematic preamp.kicad_sch]

Parts:
C1, C4, C10, C12, C17: 1µ; C_Rect_WIMA_1uF_CNC_LargePads
C2, C14: 47µ; CP_Radial_D5.0mm_P2.00mm_largerpads
C3: 47p; C_Disc_D4.3mm_W1.9mm_P5.00mm_largerpads
C7: 15n; C_Rect_L13.0mm_W4.0mm_P10.00mm_FKS3_FKP3_MKS4
C8: 100p; C_Rect_WIMA_1uF_CNC_LargePads
C9: 470n; C_Rect_L26.5mm_W10.5mm_P22.50mm_MKS4
C11: 4µ7; CP_Radial_D5.0mm_P2.00mm_largerpads
C13, C16: 470µ; CP_Radial_220u_12.5mm_5mm_largerpads
C15: 1n; C_Rect_WIMA_1uF_CNC_LargePads
D1, D2, D3, D4, D5: 1N4148; D_DO-35_SOD27_P7.62mm_Horizontal_largerpads
H1, H2, H3, H4: MountingHole; MountingHole_3.5mm
IN1: JST_XH_B2B-XH-A_1x02_P2.50mm_Vertical_ovalpads
OUT1: JST_XH_B2B-XH-A_1x02_P2.50mm_Vertical_ovalpads
P1, P2, P3: JST_XH_B3B-XH-A_1x03_P2.50mm_Vertical_ovalpads
P4b1: JST_XH_B2B-XH-A_1x02_P2.50mm_Vertical_ovalpads
Q1, Q3, Q5: BC546B; TO-92_Inline_Wide_largerpads
Q2: BC556B; TO-92_Inline_Wide_largerpads
R1, R13, R21: 100; R_Axial_DIN0207_L6.3mm_D2.5mm_P10.16mm_Horizontal_LargerPads
R2, R12, R18: 10k; R_Axial_DIN0207_L6.3mm_D2.5mm_P10.16mm_Horizontal_LargerPads
R3: 56k; R_Axial_DIN0207_L6.3mm_D2.5mm_P10.16mm_Horizontal_LargerPads
R4: 200K; R_Axial_DIN0207_L6.3mm_D2.5mm_P10.16mm_Horizontal_LargerPads
R5: 10Meg; R_Axial_DIN0207_L6.3mm_D2.5mm_P10.16mm_Horizontal_LargerPads
R6: 2K2; R_Axial_DIN0207_L6.3mm_D2.5mm_P10.16mm_Horizontal_LargerPads
R7: 620; R_Axial_DIN0207_L6.3mm_D2.5mm_P10.16mm_Horizontal_LargerPads
R8: 330; R_Axial_DIN0207_L6.3mm_D2.5mm_P10.16mm_Horizontal_LargerPads
R9: 47k; R_Axial_DIN0207_L6.3mm_D2.5mm_P10.16mm_Horizontal_LargerPads
R10: 470; R_Axial_DIN0207_L6.3mm_D2.5mm_P10.16mm_Horizontal_LargerPads
R11: 22k; R_Axial_DIN0207_L6.3mm_D2.5mm_P10.16mm_Horizontal_LargerPads
R14, R15: 47; R_Axial_DIN0207_L6.3mm_D2.5mm_P10.16mm_Horizontal_LargerPads
R16: 1k; R_Axial_DIN0207_L6.3mm_D2.5mm_P10.16mm_Horizontal_LargerPads
R17: 330K; R_Axial_DIN0207_L6.3mm_D2.5mm_P10.16mm_Horizontal_LargerPads
R19: 110k; R_Axial_DIN0207_L6.3mm_D2.5mm_P10.16mm_Horizontal_LargerPads
R20, R25: 120k; R_Axial_DIN0207_L6.3mm_D2.5mm_P10.16mm_Horizontal_LargerPads
R23: 200k; R_Axial_DIN0207_L6.3mm_D2.5mm_P10.16mm_Horizontal_LargerPads
R24: 22; R_Axial_DIN0207_L6.3mm_D2.5mm_P10.16mm_Horizontal_LargerPads
RV4: 47k; Potentiometer_Piher_PT-6-V_Vertical_largerpads
Vcc1: JST_XH_B2B-XH-A_1x02_P2.50mm_Vertical_ovalpads

Connections:
0: C2.2, C8.2, C9.2, C13.2, C16.2, D3.1 (+), D4.2 (-), IN1.2, OUT1.2, P3.3, P4b1.2, R2.2, R5.2, R8.2, R9.2, R11.2, R13.2, R18.2, R19.2, R23.2, Vcc1.2
/POW: R1.1, R21.1, Vcc1.1
/POW_Q2Q5: C16.1, Q2.3 (E), Q5.1 (C), R1.2, R3.1, R6.1, R20.1
/POW_Q3: C13.1, Q3.1 (C), R17.2, R21.2
unnamed: C1.1, R16.2
unnamed: C2.1, R3.2, R11.1, RV4.3
unnamed: C4.1, R9.1, R10.2
unnamed: C9.1, R14.1, R15.2
unnamed: C11.2, R20.2, R23.1, R25.2
unnamed: C14.1, R24.2
unnamed: D1.1 (+), D3.2 (-)
unnamed: C7.2, D1.2 (-), D2.1 (+), R10.1, R12.1
unnamed: D2.2 (-), D5.1 (+)
unnamed: D4.1 (+), D5.2 (-)
unnamed: C1.2, IN1.1, R5.1
unnamed: OUT1.1, P3.2
unnamed: P1.1, R12.2
unnamed: P1.2, R14.2
unnamed: P1.3, R13.1
unnamed: C7.1, P2.1
unnamed: C10.2, P2.2
unnamed: P2.3, R15.1
unnamed: C12.2, P3.1
unnamed: P4b1.1, R24.1
unnamed: C17.1, Q1.2 (B), R4.2
unnamed: C3.2, Q1.1 (C), Q2.2 (B), R6.2
unnamed: C14.2, Q1.3 (E), R7.2, R8.1
unnamed: C3.1, C4.2, Q2.1 (C), R7.1
unnamed: C8.1, C10.1, Q3.2 (B), R17.1, R19.1
unnamed: C12.1, Q3.3 (E), R2.1
unnamed: C15.1, Q5.2 (B), R16.1, R25.1
unnamed: C11.1, C15.2, C17.2, Q5.3 (E), R18.1
unnamed: R4.1, RV4.1, RV4.2

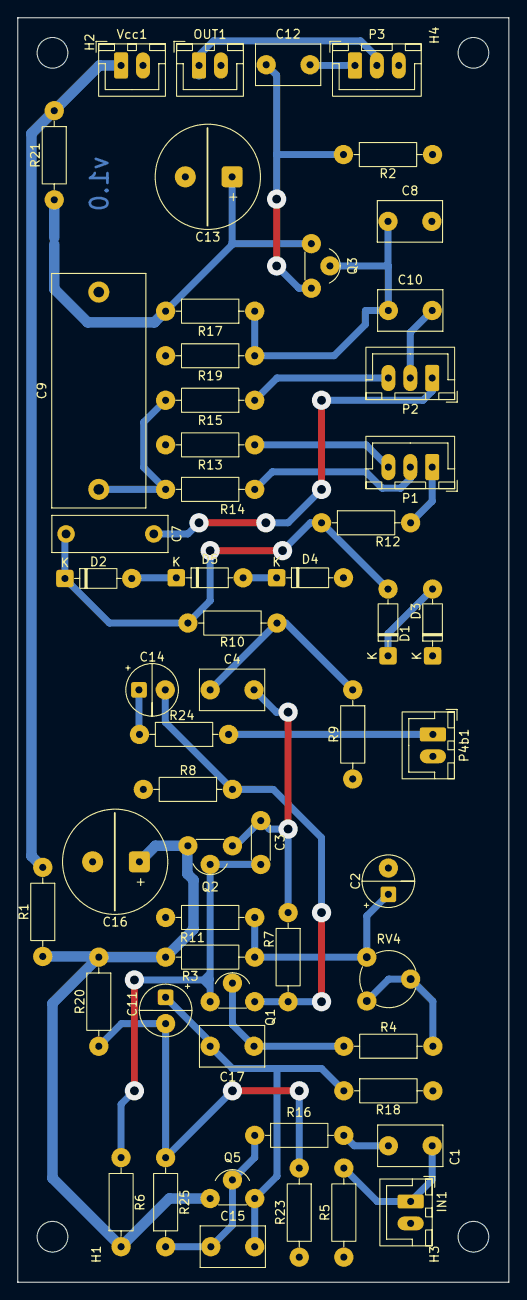
[picture p4: board preamp.kicad_pcb from above]

Board: 2 copper layers, 56.0 x 144.2 mm, 60 parts (0 on the bottom side), 33 nets.
