electrucio/electrucio_updates/junk/guitar_preamplifier/kicad/p27_amppower/p27_amppower.kicad_pcb

## KiCad design junk/guitar_preamplifier/kicad/p27_amppower/p27_amppower.kicad_pcb (2026-03-17)

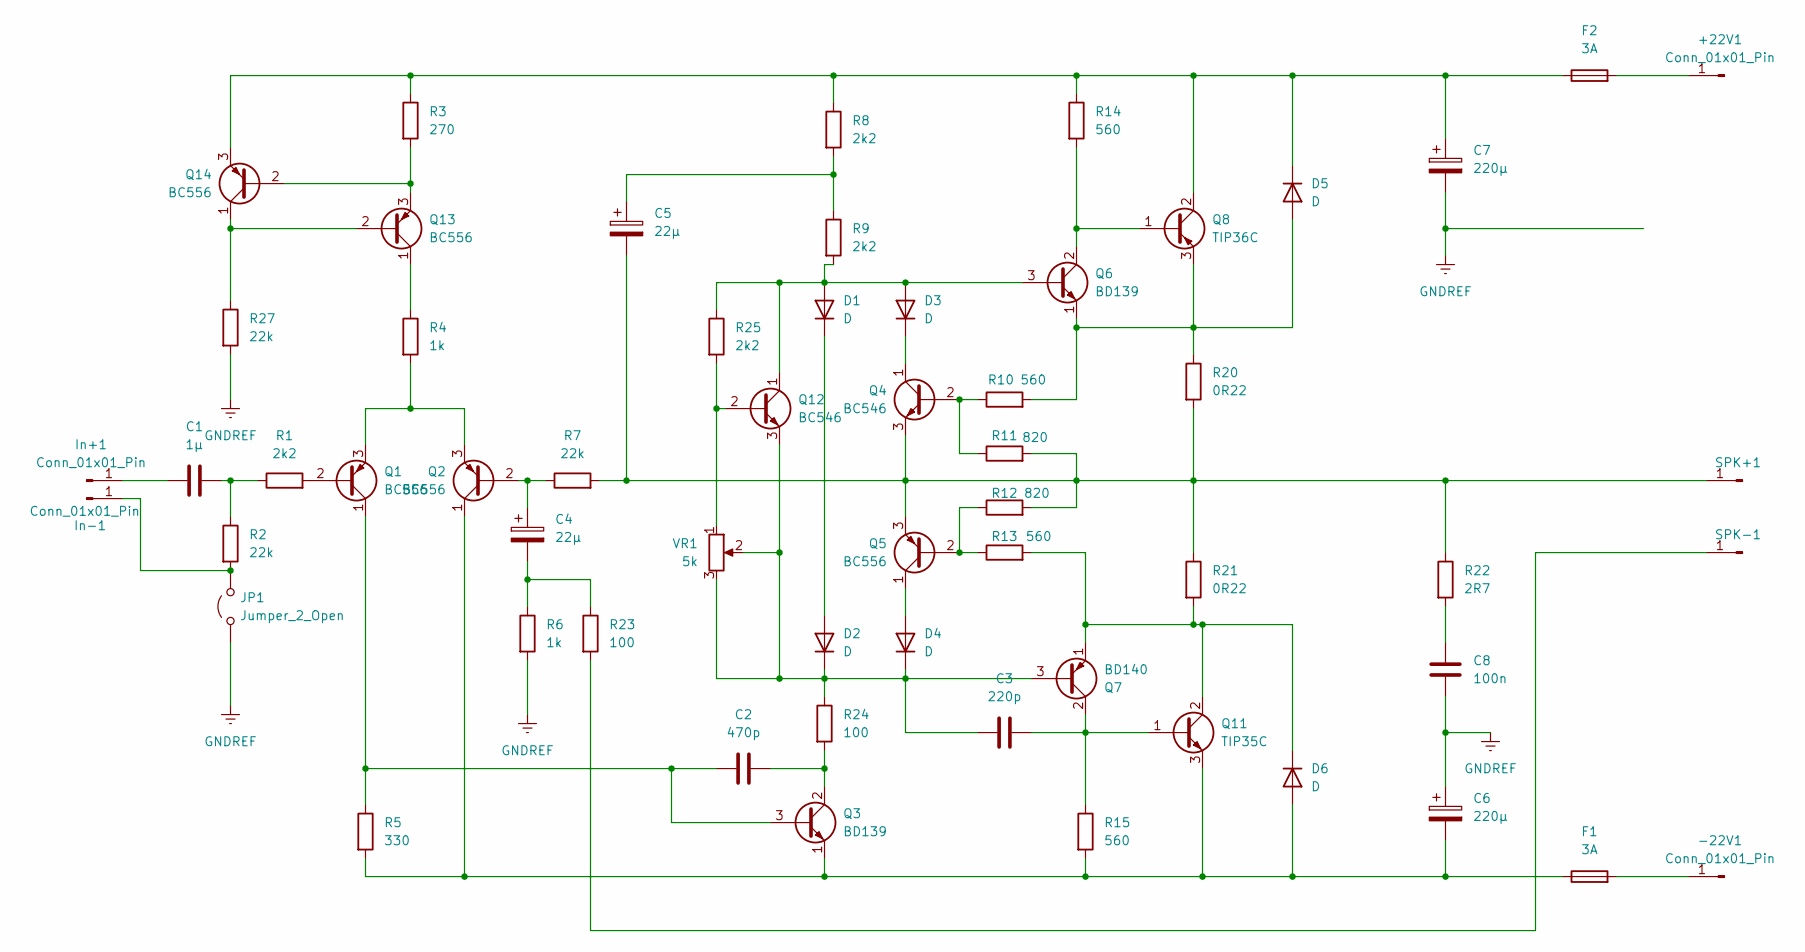
[picture p5: schematic p27_amppower.kicad_sch]

Parts:
+22V1: Conn_01x01_Pin; PinHeader_1x01_P2.54mm_Vertical
-22V1: Conn_01x01_Pin; PinHeader_1x01_P2.54mm_Vertical
C1: 1µ; C_Disc_D3.0mm_W1.6mm_P2.50mm
C2: 470p; C_Disc_D3.0mm_W1.6mm_P2.50mm
C3: 220p; C_Disc_D3.0mm_W1.6mm_P2.50mm
C4, C5: 22µ; C_Radial_D4.0mm_H7.0mm_P1.50mm
C6, C7: 220µ; CP_Radial_D10.0mm_P5.00mm
C8: 100n; C_Disc_D3.0mm_W1.6mm_P2.50mm
D1, D2, D3, D4, D5, D6: D; D_DO-35_SOD27_P7.62mm_Horizontal
F1, F2: 3A; Fuseholder_Clip-5x20mm_Littelfuse_100_Inline_P20.50x4.60mm_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
In+1: Conn_01x01_Pin; PinHeader_1x01_P2.54mm_Vertical
In-1: Conn_01x01_Pin; PinHeader_1x01_P2.54mm_Vertical
JP1: Jumper_2_Open; R_Axial_DIN0207_L6.3mm_D2.5mm_P10.16mm_Horizontal
Q1, Q2, Q5, Q13, Q14: BC556; TO-92_Inline
Q3, Q6: BD139; TO-126-3_Vertical
Q4, Q12: BC546; TO-92_Inline
Q7: BD140; TO-126-3_Vertical
Q8: TIP36C; TO-247-3_Vertical
Q11: TIP35C; TO-247-3_Vertical
R1, R8, R9, R25: 2k2; R_Axial_DIN0207_L6.3mm_D2.5mm_P10.16mm_Horizontal
R2, R7, R27: 22k; R_Axial_DIN0207_L6.3mm_D2.5mm_P10.16mm_Horizontal
R3: 270; R_Axial_DIN0207_L6.3mm_D2.5mm_P10.16mm_Horizontal
R4, R6: 1k; R_Axial_DIN0207_L6.3mm_D2.5mm_P10.16mm_Horizontal
R5: 330; R_Axial_DIN0207_L6.3mm_D2.5mm_P7.62mm_Horizontal
R10, R13, R14, R15: 560; R_Axial_DIN0207_L6.3mm_D2.5mm_P10.16mm_Horizontal
R11, R12: 820; R_Axial_DIN0207_L6.3mm_D2.5mm_P10.16mm_Horizontal
R20, R21: 0R22; R_Axial_Power_L25.0mm_W9.0mm_P27.94mm
R22: 2R7; R_Axial_DIN0207_L6.3mm_D2.5mm_P10.16mm_Horizontal
R23, R24: 100; R_Axial_DIN0207_L6.3mm_D2.5mm_P10.16mm_Horizontal
SPK+1: Conn_01x01_Pin; PinHeader_1x01_P2.54mm_Vertical
SPK-1: Conn_01x01_Pin; PinHeader_1x01_P2.54mm_Vertical
VR1: 5k; Potentiometer_Bourns_3296W_Vertical

Connections:
GNDREF: C6.1, C7.2, C8.2, JP1.1 (A), R6.2, R27.2
unnamed: +22V1.1, F2.2
unnamed: -22V1.1, F1.2
unnamed: C1.1, R1.1, R2.1
unnamed: C4.2, R6.1, R23.1
unnamed: C5.1, R8.2, R9.1
unnamed: C8.1, R22.2
unnamed: D1.2 (A), D3.2 (A), Q6.3 (B), Q12.1 (C), R9.2, R25.1
unnamed: D1.1 (K), D2.2 (A)
unnamed: C3.2, D2.1 (K), D4.1 (K), Q7.3 (B), Q12.3 (E), R24.1, VR1.2, VR1.3
unnamed: D3.1 (K), Q4.1 (C)
unnamed: D4.2 (A), Q5.1 (C)
unnamed: D5.2 (A), Q6.1 (E), Q8.3 (E), R10.2, R20.1
unnamed: C7.1, D5.1 (K), F2.1, Q8.2 (C), Q14.3 (E), R3.1, R8.1, R14.1
unnamed: C6.2, D6.2 (A), F1.1, Q2.1 (C), Q3.1 (E), Q11.3 (E), R5.2, R15.2
unnamed: D6.1 (K), Q7.1 (E), Q11.2 (C), R13.2, R21.2
unnamed: C1.2, In+1.1
unnamed: In-1.1, JP1.2 (B), R2.2
unnamed: Q1.2 (B), R1.2
unnamed: C2.2, Q1.1 (C), Q3.3 (B), R5.1
unnamed: Q1.3 (E), Q2.3 (E), R4.2
unnamed: C4.1, Q2.2 (B), R7.1
unnamed: C2.1, Q3.2 (C), R24.2
unnamed: Q4.2 (B), R10.1, R11.1
unnamed: C5.2, Q4.3 (E), Q5.3 (E), R7.2, R11.2, R12.2, R20.2, R21.1, R22.1, SPK+1.1
unnamed: Q5.2 (B), R12.1, R13.1
unnamed: Q6.2 (C), Q8.1 (B), R14.2
unnamed: C3.1, Q7.2 (C), Q11.1 (B), R15.1
unnamed: Q12.2 (B), R25.2, VR1.1
unnamed: Q13.2 (B), Q14.1 (C), R27.1
unnamed: Q13.1 (C), R4.1
unnamed: Q13.3 (E), Q14.2 (B), R3.2
unnamed: R23.2, SPK-1.1

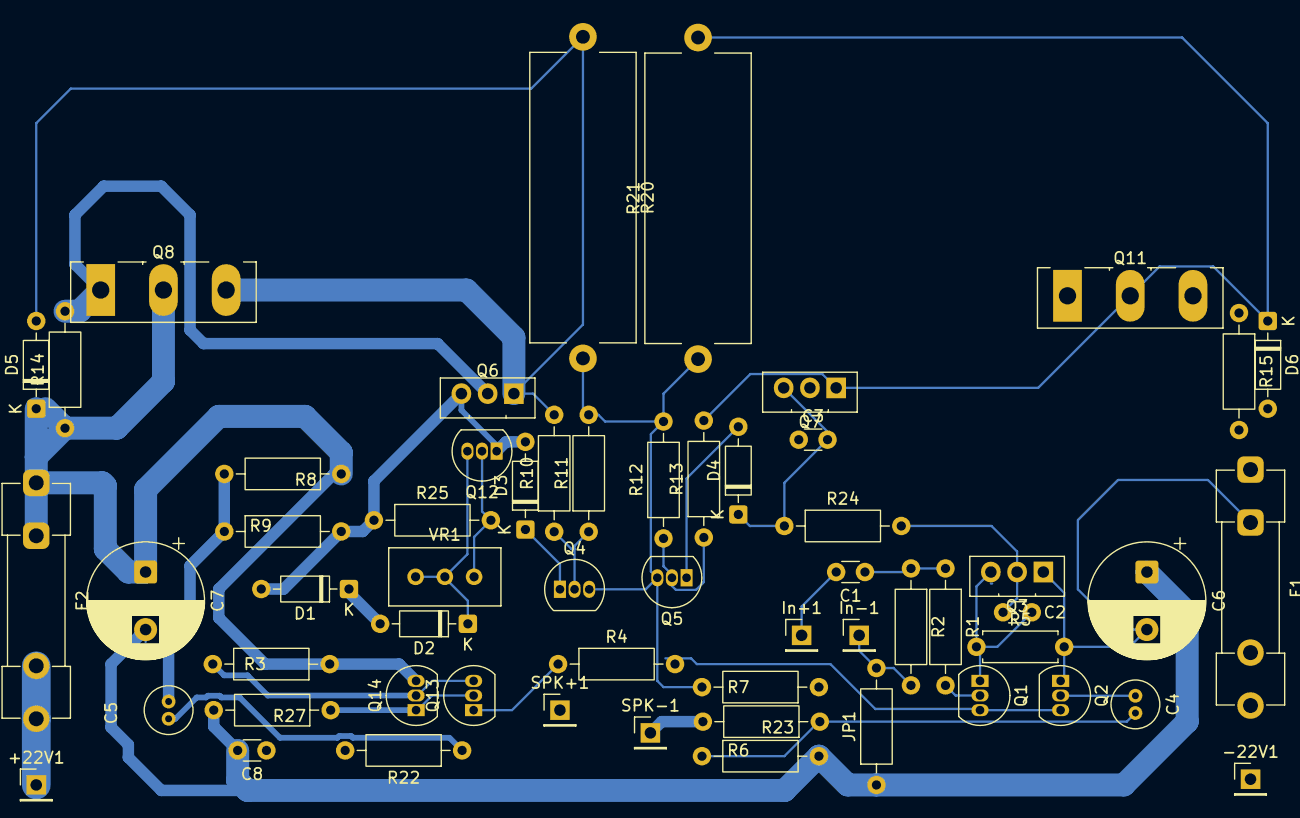
[picture p6: board p27_amppower.kicad_pcb from above]

Board: 2 copper layers, 58 parts (0 on the bottom side), 33 nets.
