electrucio/electrucio_updates/(commit log)

2026-03-09 Add chat with Gemini to improve red circuits design
2026-03-17 Add p27_amppower
    [PCB_PCB_jlh1969_2026-03-17.json, SCH_jlh1969_2026-03-17.json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]
2026-03-22 Update redesign_15v.asc with new diode clipping approach
2026-04-29 Update preamp15v
    [preamp15v.kicad_pcb, preamp15v.kicad_sch]
2026-05-02 Move temporary experiments to junk directory
    [PCB_PCB_jlh1969_2026-03-17.json, SCH_jlh1969_2026-03-17.json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]
2026-05-03 Add power_supply_unit.asc
2026-06-14 Update guitar amplifier files
    [poweramp.kicad_pcb, poweramp.kicad_sch, preamp.kicad_pcb, preamp.kicad_sch]
2026-06-14 Update files
    [poweramp.kicad_pcb, poweramp.kicad_sch]
2026-06-14 Add html viewer for power amp guitar amplifier
2026-06-14 Add power supply
